Arii-git/ATLAS-DIAG/firmware/Core/Inc/main.h

#define B1_Pin GPIO_PIN_13
#define B1_GPIO_Port GPIOC
#define DUT1_Pin GPIO_PIN_2
#define DUT1_GPIO_Port GPIOC
#define DUT2_Pin GPIO_PIN_3
#define DUT2_GPIO_Port GPIOC
#define USART_TX_Pin GPIO_PIN_2
#define USART_TX_GPIO_Port GPIOA
#define USART_RX_Pin GPIO_PIN_3
#define USART_RX_GPIO_Port GPIOA
#define LD2_Pin GPIO_PIN_5
#define LD2_GPIO_Port GPIOA
#define DUT3_Pin GPIO_PIN_4
#define DUT3_GPIO_Port GPIOC
#define DUT4_Pin GPIO_PIN_5
#define DUT4_GPIO_Port GPIOC
#define DUT13_Pin GPIO_PIN_1
#define DUT13_GPIO_Port GPIOB
#define LED_PASS_Pin GPIO_PIN_12
#define LED_PASS_GPIO_Port GPIOB
#define DUT5_Pin GPIO_PIN_6
#define DUT5_GPIO_Port GPIOC
#define DUT6_Pin GPIO_PIN_7
#define DUT6_GPIO_Port GPIOC
#define DUT8_Pin GPIO_PIN_9
#define DUT8_GPIO_Port GPIOC
#define LED_FAULT1_Pin GPIO_PIN_8
#define LED_FAULT1_GPIO_Port GPIOA
#define EXT_BUT_Pin GPIO_PIN_10
#define EXT_BUT_GPIO_Port GPIOA
#define TMS_Pin GPIO_PIN_13
#define TMS_GPIO_Port GPIOA
#define TCK_Pin GPIO_PIN_14
#define TCK_GPIO_Port GPIOA
#define DUT9_Pin GPIO_PIN_10
#define DUT9_GPIO_Port GPIOC
#define DUT10_Pin GPIO_PIN_11
#define DUT10_GPIO_Port GPIOC
#define DUT11_Pin GPIO_PIN_12
#define DUT11_GPIO_Port GPIOC
#define DUT12_Pin GPIO_PIN_2
#define DUT12_GPIO_Port GPIOD
#define SWO_Pin GPIO_PIN_3
#define SWO_GPIO_Port GPIOB
