Arii-git/ATLAS-DIAG/(commit log)

2026-10-28 ATLAS-DIAG v1.0.0: firmware, digital twin, dashboard, data and docs
    [atlas_history.csv, compaction_stats.csv, session_2026-10-28_2118.csv]
2026-10-29 Docs: wiring table matches the final build
